phase2682/SOTA_TriBander_LCD/Layout Files/Relay_LCD k7 back.jpg

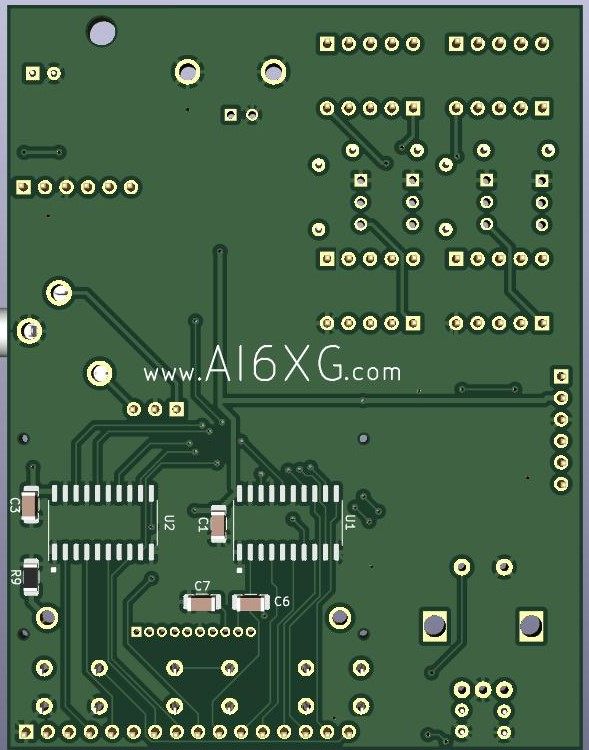
Layout Files/Relay_LCD k7 back.jpg
