phase2682/SOTA_TriBander_LCD/Layout Files/Relay_LCD k7 front.jpg

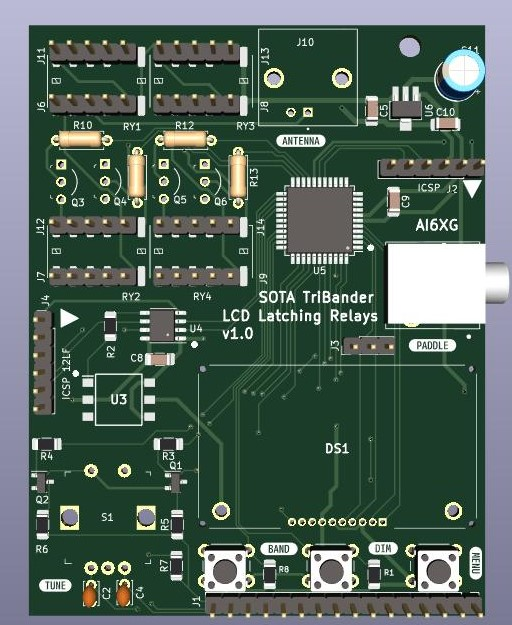
Layout Files/Relay_LCD k7 front.jpg
