phase2682/SOTA_TriBander_LCD/README.md

# SOTA_TriBander_LCD
Replacing the LED display with a LCD on the SOTA  Tri-Bander CW transceiver
https://www.ai6xg.com/post/lcd-display-for-the-kd1jv-tribander
