phase2682/SOTA_TriBander_LCD/Schematics/Relay_LCD k7.pdf

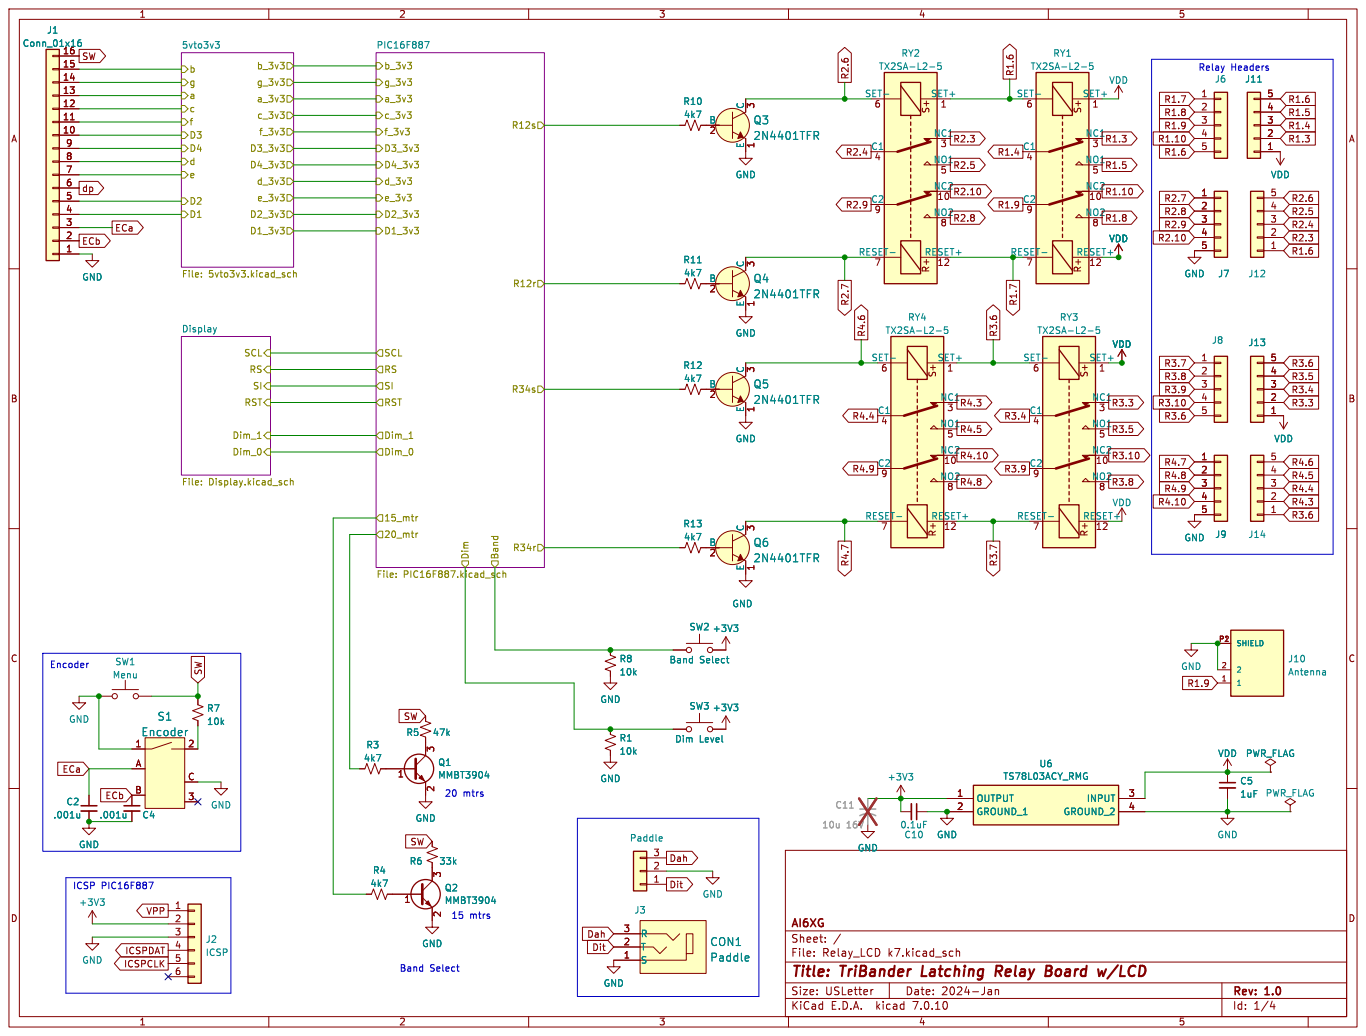
[picture p3: page 1]

Dah Dit Dah Dit ICSPDAT

Id: 1/4 Title: TriBander Latching Relay Board w/LCD

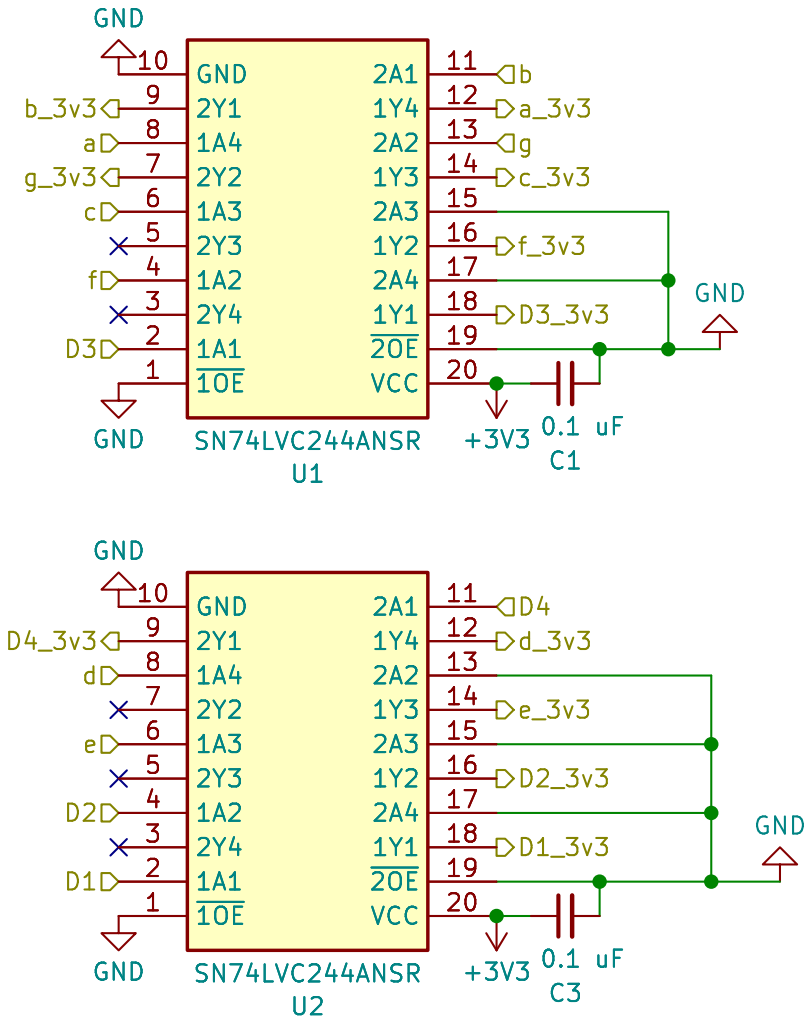
[picture p4: page 2]

Id: 2/4 Title: TriBander Latching Relay Board w/LCD

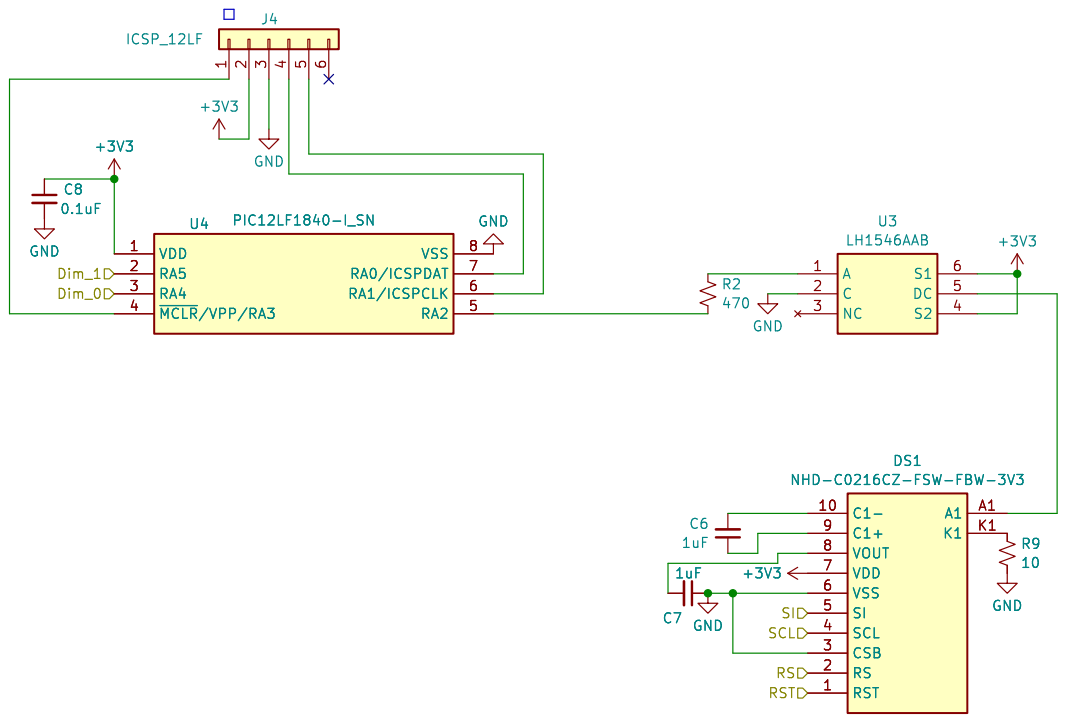
[picture p5: page 3]

File: Display.kicad_sch Sheet: /Display/ AI6XG

Id: 3/4 Title: TriBander Latching Relay Board w/LCD

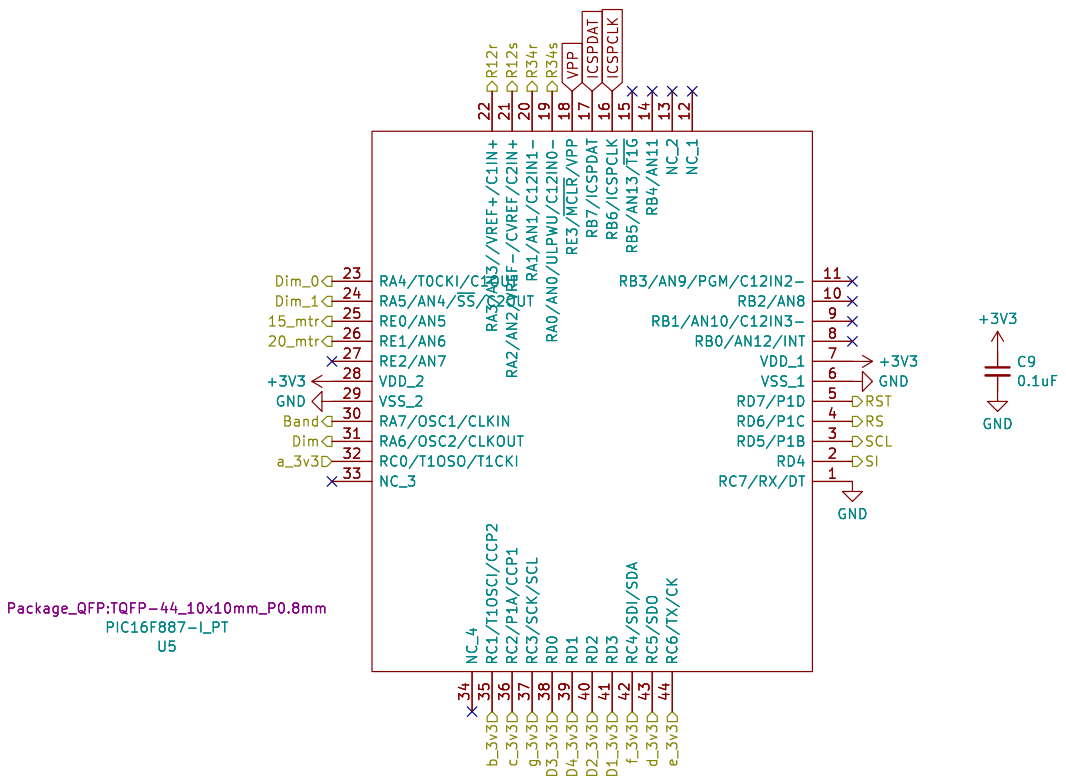
[picture p6: page 4]

Id: 4/4 Title: TriBander Latching Relay Board w/LCD
