phase2682/SOTA_TriBander_LCD/Layout Files/Relay_LCD k7.kicad_pcb

## KiCad design Layout Files/Relay_LCD k7.kicad_pcb (2024-05-09)

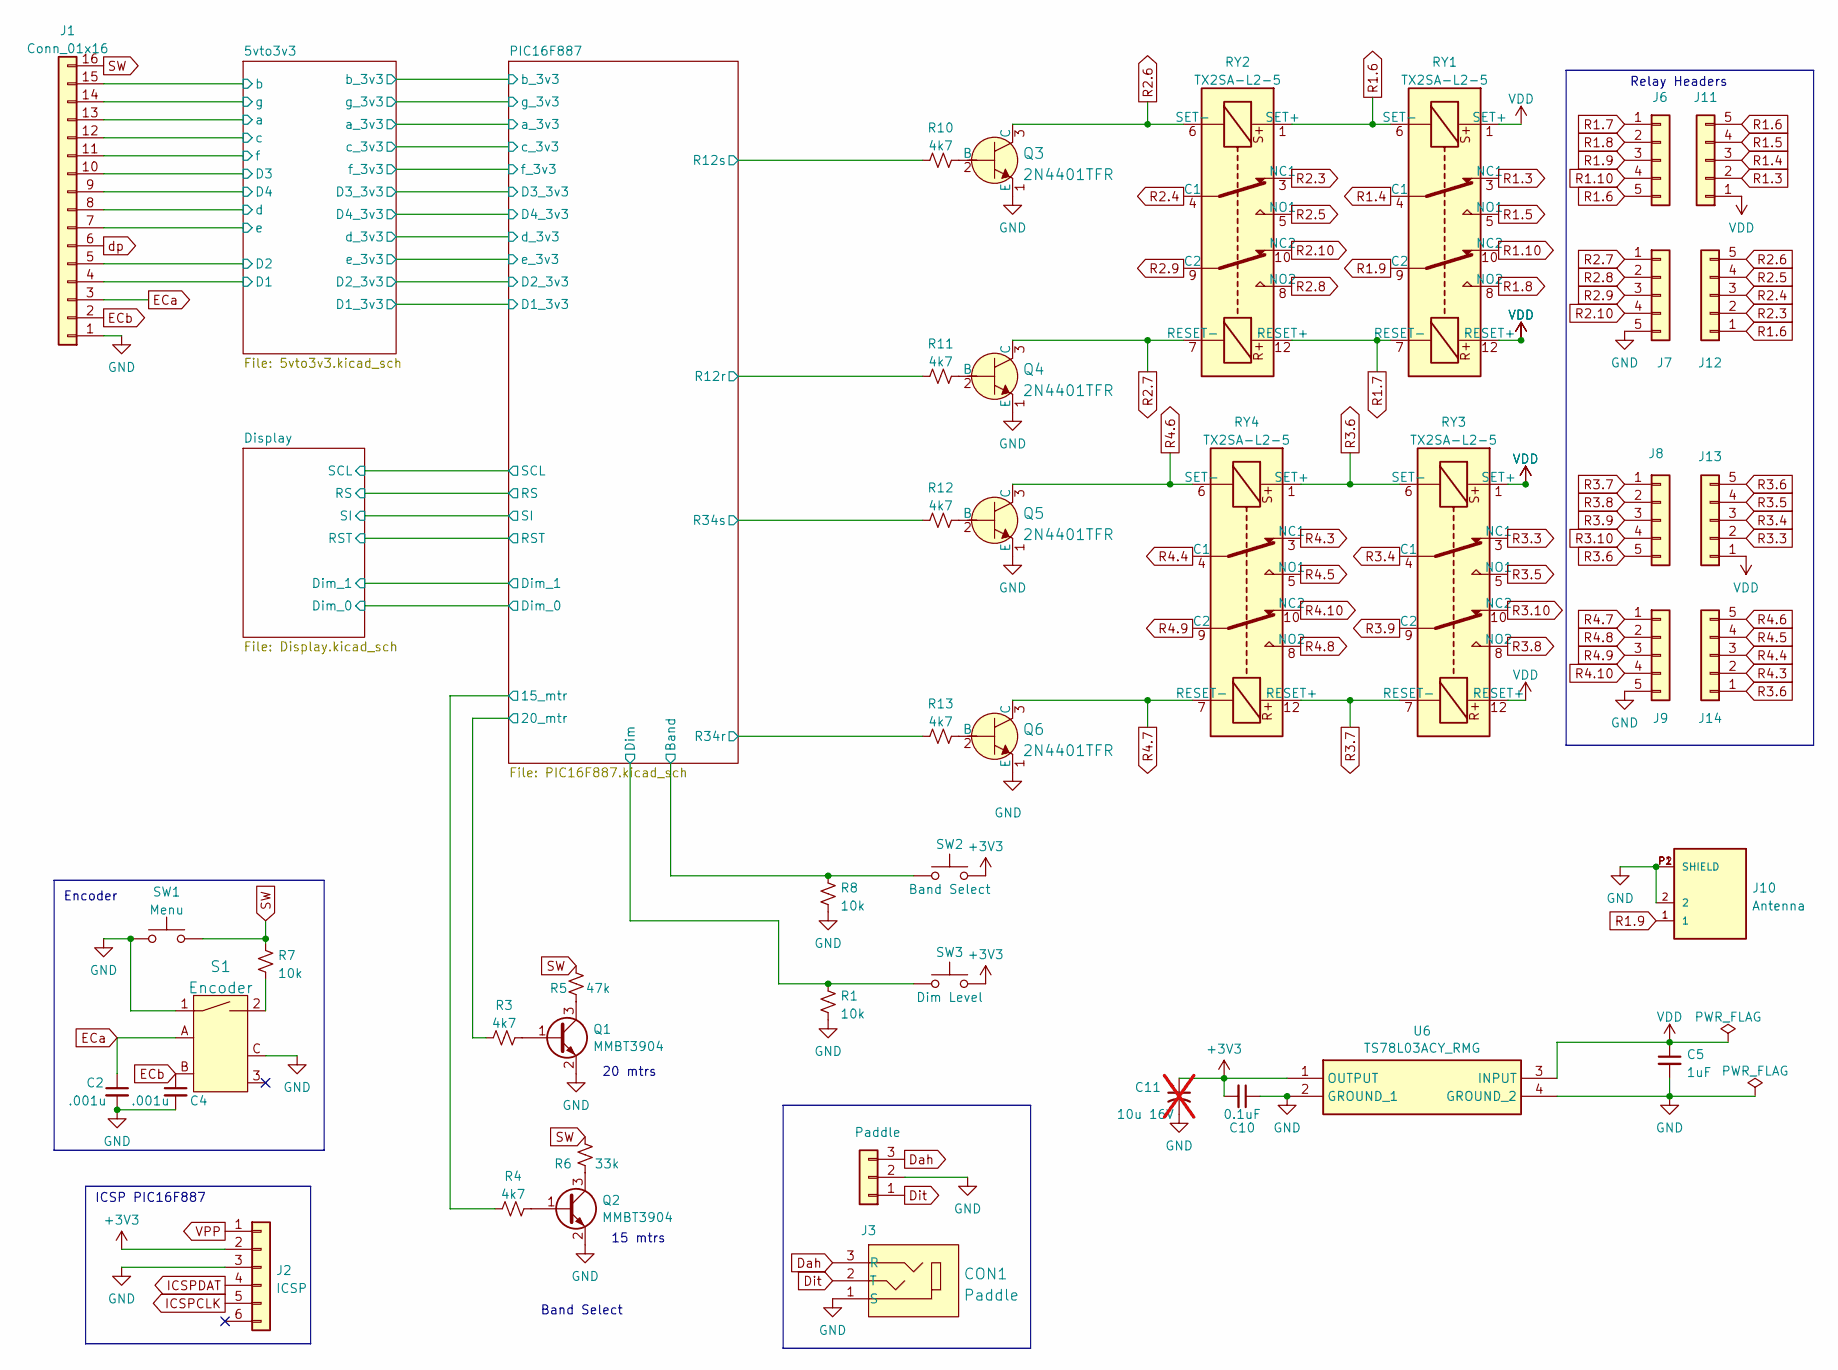
[picture p7: schematic Relay_LCD k7.kicad_sch, TriBander Latching Relay Board w/LCD]

Parts:
C2, C4: .001u; C_Disc_D3.4mm_W2.1mm_P2.50mm
C5: 1uF; C_1206_3216Metric_Pad1.33x1.80mm_HandSolder
C10: 0.1uF; C_1206_3216Metric_Pad1.33x1.80mm_HandSolder
C11: 10u 16V; CP_Radial_D6.3mm_P2.50mm; not fitted
CON1: Paddle; CUI_SJ1-3513N round pin; MPN SJ1-3523N; Digi-Key_PN CP1-3523N-ND
J1: Conn_01x16; PinHeader_1x16_P2.54mm_Vertical
J2: ICSP; PinHeader_1x06_P2.54mm_Vertical
J3: Paddle; PinHeader_1x03_P2.54mm_Vertical
J6, J7, J8, J9, J11, J12, J13, J14: Conn_01x05; PinHeader_1x05_P2.54mm_Vertical
J10: Antenna; CONN_1-1337543-0
Q1, Q2: MMBT3904; SOT-23
Q3, Q4, Q5, Q6: 2N4401TFR; TO-92-3_Formed_Leads; MPN 2N4401TFR; Digi-Key_PN 2N4401D26ZCT-ND
R1, R7, R8: 10k; R_1206_3216Metric_Pad1.30x1.75mm_HandSolder
R3, R4: 4k7; R_1206_3216Metric_Pad1.30x1.75mm_HandSolder
R5: 47k; R_1206_3216Metric_Pad1.30x1.75mm_HandSolder
R6: 33k; R_1206_3216Metric_Pad1.30x1.75mm_HandSolder
R10, R11, R12, R13: 4k7; R THT .25W minP
RY1, RY2, RY3, RY4: TX2SA-L2-5; Relay_DPDT_Kemet_EE2_NU_DoubleCoil
S1: Encoder; Rotary_Encoder_Switched_PEC11R; MPN PEC11R-4215F-S0024; Digi-Key_PN PEC11R-4215F-S0024-ND
SW1: Menu; SW_PUSH_6mm
SW2: Band Select; SW_PUSH_6mm
SW3: Dim Level; SW_PUSH_6mm
U6: TS78L03ACY_RMG; SOT-89-3_Handsoldering; Mouser Part Number 821-TS78L03ACYRMG

Connections:
+3V3: C10.2, C11.1, J2.2, SW2.2, SW3.2, U6.1 (OUTPUT); also elsewhere on the board
/5vto3v3/D1: J1.4; also elsewhere on the board
/5vto3v3/D2: J1.5; also elsewhere on the board
/5vto3v3/D3: J1.10; also elsewhere on the board
/5vto3v3/D4: J1.9; also elsewhere on the board
/5vto3v3/a: J1.13; also elsewhere on the board
/5vto3v3/b: J1.15; also elsewhere on the board
/5vto3v3/c: J1.12; also elsewhere on the board
/5vto3v3/d: J1.8; also elsewhere on the board
/5vto3v3/e: J1.7; also elsewhere on the board
/5vto3v3/f: J1.11; also elsewhere on the board
/5vto3v3/g: J1.14; also elsewhere on the board
/PIC16F887/15_mtr: R4.1; also elsewhere on the board
/PIC16F887/20_mtr: R3.1; also elsewhere on the board
/PIC16F887/Band: R8.2, SW2.1; also elsewhere on the board
/PIC16F887/Dim: R1.2, SW3.1; also elsewhere on the board
/PIC16F887/R12r: R11.1; also elsewhere on the board
/PIC16F887/R12s: R10.1; also elsewhere on the board
/PIC16F887/R34r: R13.1; also elsewhere on the board
/PIC16F887/R34s: R12.1; also elsewhere on the board
Dah: CON1.3 (R), J3.3
Dit: CON1.2 (T), J3.1
ECa: C2.1, J1.3, S1.A (CH_A)
ECb: C4.1, J1.2, S1.B (CH_B)
GND: C2.2, C4.2, C5.2, C10.1, C11.2, CON1.1 (S), J1.1, J2.3, J3.2, J7.5, J9.5, J10.2, J10.P1 (SHIELD), J10.P2 (SHIELD), Q1.2 (E), Q2.2 (E), Q3.1 (E), Q4.1 (E), Q5.1 (E), Q6.1 (E), R1.1, R8.1, S1.1, S1.C (COM), SW1.1, U6.2 (GROUND_1), U6.4 (GROUND_2); also elsewhere on the board
ICSPCLK: J2.5; also elsewhere on the board
ICSPDAT: J2.4; also elsewhere on the board
unnamed: Q1.1 (B), R3.2
unnamed: Q1.3 (C), R5.2
unnamed: Q2.1 (B), R4.2
unnamed: Q2.3 (C), R6.2
unnamed: Q3.2 (B), R10.2
unnamed: Q4.2 (B), R11.2
unnamed: Q5.2 (B), R12.2
unnamed: Q6.2 (B), R13.2
unnamed: R7.2, S1.2
R1.3: J11.2, RY1.3 (NC1)
R1.4: J11.3, RY1.4 (C1)
R1.5: J11.4, RY1.5 (NO1)
R1.6: J6.5, J11.5, J12.1, RY1.6 (SET-), RY2.1 (SET+)
R1.7: J6.1, RY1.7 (RESET-), RY2.12 (RESET+)
R1.8: J6.2, RY1.8 (NO2)
R1.9: J6.3, J10.1, RY1.9 (C2)
R1.10: J6.4, RY1.10 (NC2)
R2.3: J12.2, RY2.3 (NC1)
R2.4: J12.3, RY2.4 (C1)
R2.5: J12.4, RY2.5 (NO1)
R2.6: J12.5, Q3.3 (C), RY2.6 (SET-)
R2.7: J7.1, Q4.3 (C), RY2.7 (RESET-)
R2.8: J7.2, RY2.8 (NO2)
R2.9: J7.3, RY2.9 (C2)
R2.10: J7.4, RY2.10 (NC2)
R3.3: J13.2, RY3.3 (NC1)
R3.4: J13.3, RY3.4 (C1)
R3.5: J13.4, RY3.5 (NO1)
R3.6: J8.5, J13.5, J14.1, RY3.6 (SET-), RY4.1 (SET+)
R3.7: J8.1, RY3.7 (RESET-), RY4.12 (RESET+)
R3.8: J8.2, RY3.8 (NO2)
R3.9: J8.3, RY3.9 (C2)
R3.10: J8.4, RY3.10 (NC2)
R4.3: J14.2, RY4.3 (NC1)
R4.4: J14.3, RY4.4 (C1)
R4.5: J14.4, RY4.5 (NO1)
R4.6: J14.5, Q5.3 (C), RY4.6 (SET-)
R4.7: J9.1, Q6.3 (C), RY4.7 (RESET-)
R4.8: J9.2, RY4.8 (NO2)
R4.9: J9.3, RY4.9 (C2)
R4.10: J9.4, RY4.10 (NC2)
SW: J1.16, R5.1, R6.1, R7.1, SW1.2
VDD: C5.1, J11.1, J13.1, RY1.1 (SET+), RY1.12 (RESET+), RY3.1 (SET+), RY3.12 (RESET+), U6.3 (INPUT)
VPP: J2.1; also elsewhere on the board
dp: J1.6

Notes on the sheet:
20 mtrs
15 mtrs
Relay Headers
ICSP PIC16F887
Encoder
Band Select

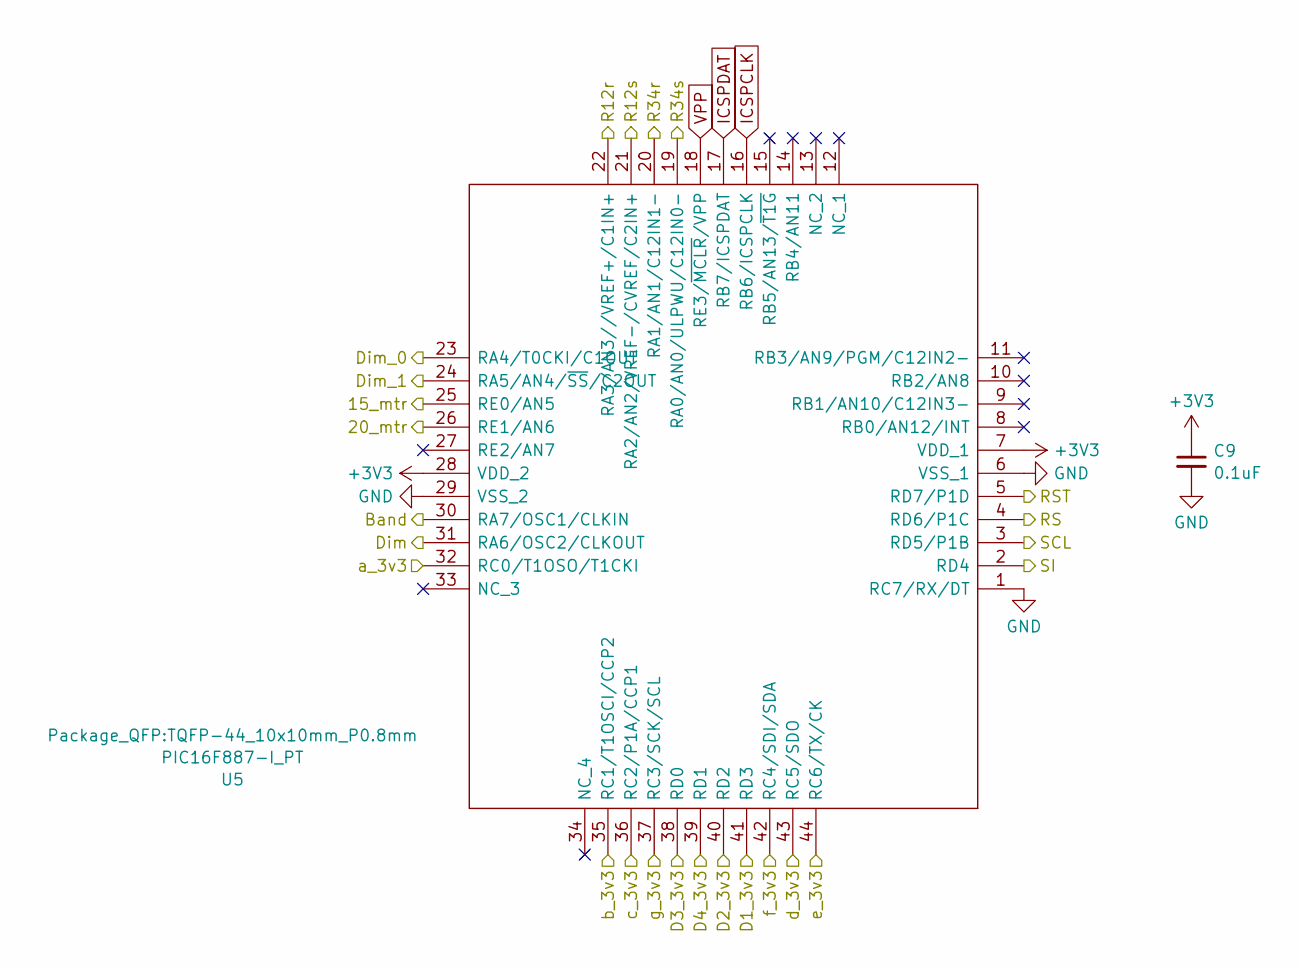
[picture p8: schematic PIC16F887.kicad_sch, TriBander Latching Relay Board w/LCD]

Parts:
C9: 0.1uF; C_1206_3216Metric_Pad1.33x1.80mm_HandSolder
U5: PIC16F887-I_PT; TQFP-44_10x10mm_P0.8mm; Mouser Part Number 579-PIC16F887-I/PT

Connections:
+3V3: C9.1, U5.7 (VDD_1), U5.28 (VDD_2); also elsewhere on the board
/5vto3v3/D1_3v3: U5.41 (RD3); also elsewhere on the board
/5vto3v3/D2_3v3: U5.40 (RD2); also elsewhere on the board
/5vto3v3/D3_3v3: U5.38 (RD0); also elsewhere on the board
/5vto3v3/D4_3v3: U5.39 (RD1); also elsewhere on the board
/5vto3v3/a_3v3: U5.32 (RC0/T1OSO/T1CKI); also elsewhere on the board
/5vto3v3/b_3v3: U5.35 (RC1/T1OSCI/CCP2); also elsewhere on the board
/5vto3v3/c_3v3: U5.36 (RC2/P1A/CCP1); also elsewhere on the board
/5vto3v3/d_3v3: U5.43 (RC5/SDO); also elsewhere on the board
/5vto3v3/e_3v3: U5.44 (RC6/TX/CK); also elsewhere on the board
/5vto3v3/f_3v3: U5.42 (RC4/SDI/SDA); also elsewhere on the board
/5vto3v3/g_3v3: U5.37 (RC3/SCK/SCL); also elsewhere on the board
/Display/Dim_0: U5.23 (RA4/T0CKI/C1OUT); also elsewhere on the board
/Display/Dim_1: U5.24 (RA5/AN4/~SS/C2OUT); also elsewhere on the board
/Display/RS: U5.4 (RD6/P1C); also elsewhere on the board
/Display/RST: U5.5 (RD7/P1D); also elsewhere on the board
/Display/SCL: U5.3 (RD5/P1B); also elsewhere on the board
/Display/SI: U5.2 (RD4); also elsewhere on the board
/PIC16F887/15_mtr: U5.25 (RE0/AN5); also elsewhere on the board
/PIC16F887/20_mtr: U5.26 (RE1/AN6); also elsewhere on the board
/PIC16F887/Band: U5.30 (RA7/OSC1/CLKIN); also elsewhere on the board
/PIC16F887/Dim: U5.31 (RA6/OSC2/CLKOUT); also elsewhere on the board
/PIC16F887/R12r: U5.22 (RA3/AN3//VREF+/C1IN+); also elsewhere on the board
/PIC16F887/R12s: U5.21 (RA2/AN2/VREF-/CVREF/C2IN+); also elsewhere on the board
/PIC16F887/R34r: U5.20 (RA1/AN1/C12IN1-); also elsewhere on the board
/PIC16F887/R34s: U5.19 (RA0/AN0/ULPWU/C12IN0-); also elsewhere on the board
GND: C9.2, U5.1 (RC7/RX/DT), U5.6 (VSS_1), U5.29 (VSS_2); also elsewhere on the board
ICSPCLK: U5.16 (RB6/ICSPCLK); also elsewhere on the board
ICSPDAT: U5.17 (RB7/ICSPDAT); also elsewhere on the board
VPP: U5.18 (RE3/~MCLR/VPP); also elsewhere on the board

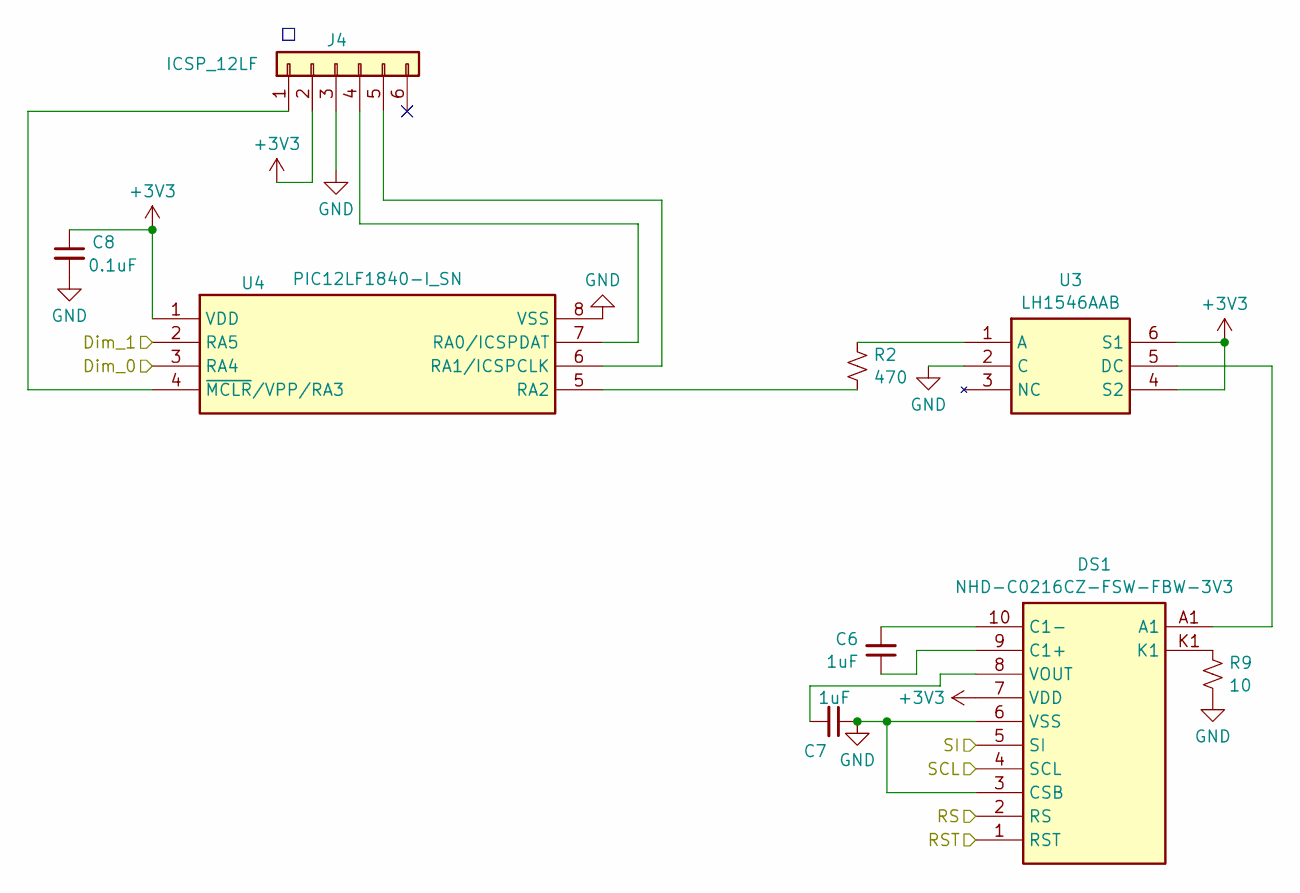
[picture p9: schematic Display.kicad_sch, TriBander Latching Relay Board w/LCD]

Parts:
C6, C7: 1uF; C_1206_3216Metric_Pad1.33x1.80mm_HandSolder
C8: 0.1uF; C_1206_3216Metric_Pad1.33x1.80mm_HandSolder
DS1: NHD-C0216CZ-FSW-FBW-3V3; NHDC0216CZFSWFBW3V3; Mouser Part Number 763-C0216CZ-FSWFBW3V
J4: ICSP_12LF; PinHeader_1x06_P2.54mm_Vertical
R2: 470; R_1206_3216Metric_Pad1.30x1.75mm_HandSolder
R9: 10; R_1206_3216Metric_Pad1.30x1.75mm_HandSolder
U3: LH1546AAB; SOP254P980X425-6N; Mouser Part Number 782-LH1546AABTR
U4: PIC12LF1840-I_SN; SO-8_3.9x4.9mm_P1.27mm; Mouser Part Number 579-PIC12LF1840-I/SN

Connections:
+3V3: C8.1, DS1.7 (VDD), J4.2, U3.4 (S2), U3.6 (S1), U4.1 (VDD); also elsewhere on the board
/Display/Dim_0: U4.3 (RA4); also elsewhere on the board
/Display/Dim_1: U4.2 (RA5); also elsewhere on the board
/Display/RS: DS1.2 (RS); also elsewhere on the board
/Display/RST: DS1.1 (RST); also elsewhere on the board
/Display/SCL: DS1.4 (SCL); also elsewhere on the board
/Display/SI: DS1.5 (SI); also elsewhere on the board
GND: C7.1, C8.2, DS1.3 (CSB), DS1.6 (VSS), J4.3, R9.2, U3.2 (C), U4.8 (VSS); also elsewhere on the board
unnamed: C6.1, DS1.9 (C1+)
unnamed: C6.2, DS1.10 (C1-)
unnamed: DS1.K1, R9.1
unnamed: C7.2, DS1.8 (VOUT)
unnamed: J4.1, U4.4 (~MCLR/VPP/RA3)
unnamed: J4.4, U4.7 (RA0/ICSPDAT)
unnamed: J4.5, U4.6 (RA1/ICSPCLK)
unnamed: R2.1, U3.1 (A)
unnamed: DS1.A1, U3.5 (DC)
unnamed: R2.2, U4.5 (RA2)

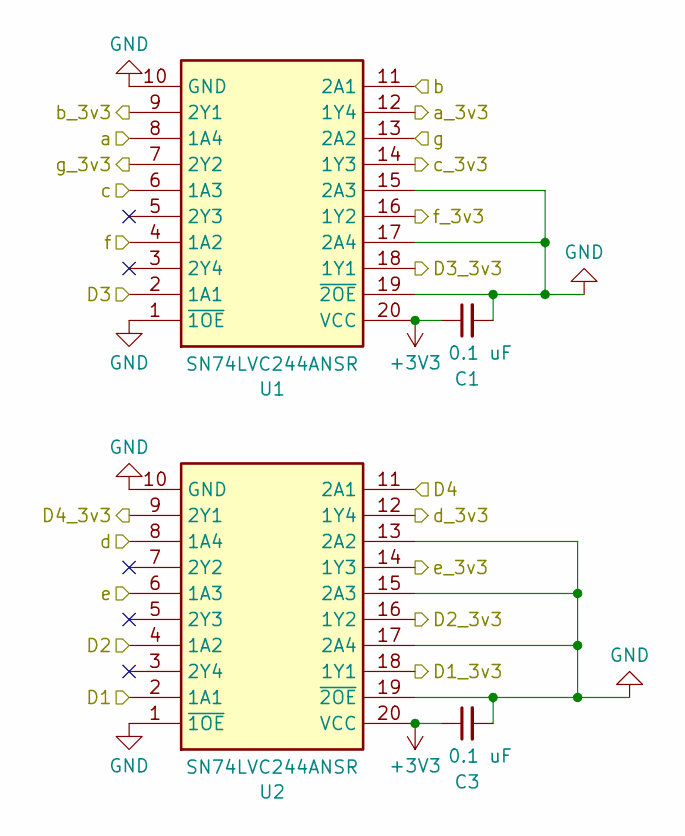
[picture p10: schematic 5vto3v3.kicad_sch, TriBander Latching Relay Board w/LCD]

Parts:
C1, C3: 0.1 uF; C_1206_3216Metric_Pad1.33x1.80mm_HandSolder
U1, U2: SN74LVC244ANSR; SO-20_5.3x12.6mm_P1.27mm; Mouser Part Number 595-SN74LVC244ANSR

Connections:
+3V3: C1.1, C3.1, U1.20 (VCC), U2.20 (VCC); also elsewhere on the board
/5vto3v3/D1: U2.2 (1A1); also elsewhere on the board
/5vto3v3/D1_3v3: U2.18 (1Y1); also elsewhere on the board
/5vto3v3/D2: U2.4 (1A2); also elsewhere on the board
/5vto3v3/D2_3v3: U2.16 (1Y2); also elsewhere on the board
/5vto3v3/D3: U1.2 (1A1); also elsewhere on the board
/5vto3v3/D3_3v3: U1.18 (1Y1); also elsewhere on the board
/5vto3v3/D4: U2.11 (2A1); also elsewhere on the board
/5vto3v3/D4_3v3: U2.9 (2Y1); also elsewhere on the board
/5vto3v3/a: U1.8 (1A4); also elsewhere on the board
/5vto3v3/a_3v3: U1.12 (1Y4); also elsewhere on the board
/5vto3v3/b: U1.11 (2A1); also elsewhere on the board
/5vto3v3/b_3v3: U1.9 (2Y1); also elsewhere on the board
/5vto3v3/c: U1.6 (1A3); also elsewhere on the board
/5vto3v3/c_3v3: U1.14 (1Y3); also elsewhere on the board
/5vto3v3/d: U2.8 (1A4); also elsewhere on the board
/5vto3v3/d_3v3: U2.12 (1Y4); also elsewhere on the board
/5vto3v3/e: U2.6 (1A3); also elsewhere on the board
/5vto3v3/e_3v3: U2.14 (1Y3); also elsewhere on the board
/5vto3v3/f: U1.4 (1A2); also elsewhere on the board
/5vto3v3/f_3v3: U1.16 (1Y2); also elsewhere on the board
/5vto3v3/g: U1.13 (2A2); also elsewhere on the board
/5vto3v3/g_3v3: U1.7 (2Y2); also elsewhere on the board
GND: C1.2, C3.2, U1.1 (~1OE), U1.10 (GND), U1.15 (2A3), U1.17 (2A4), U1.19 (~2OE), U2.1 (~1OE), U2.10 (GND), U2.13 (2A2), U2.15 (2A3), U2.17 (2A4), U2.19 (~2OE); also elsewhere on the board

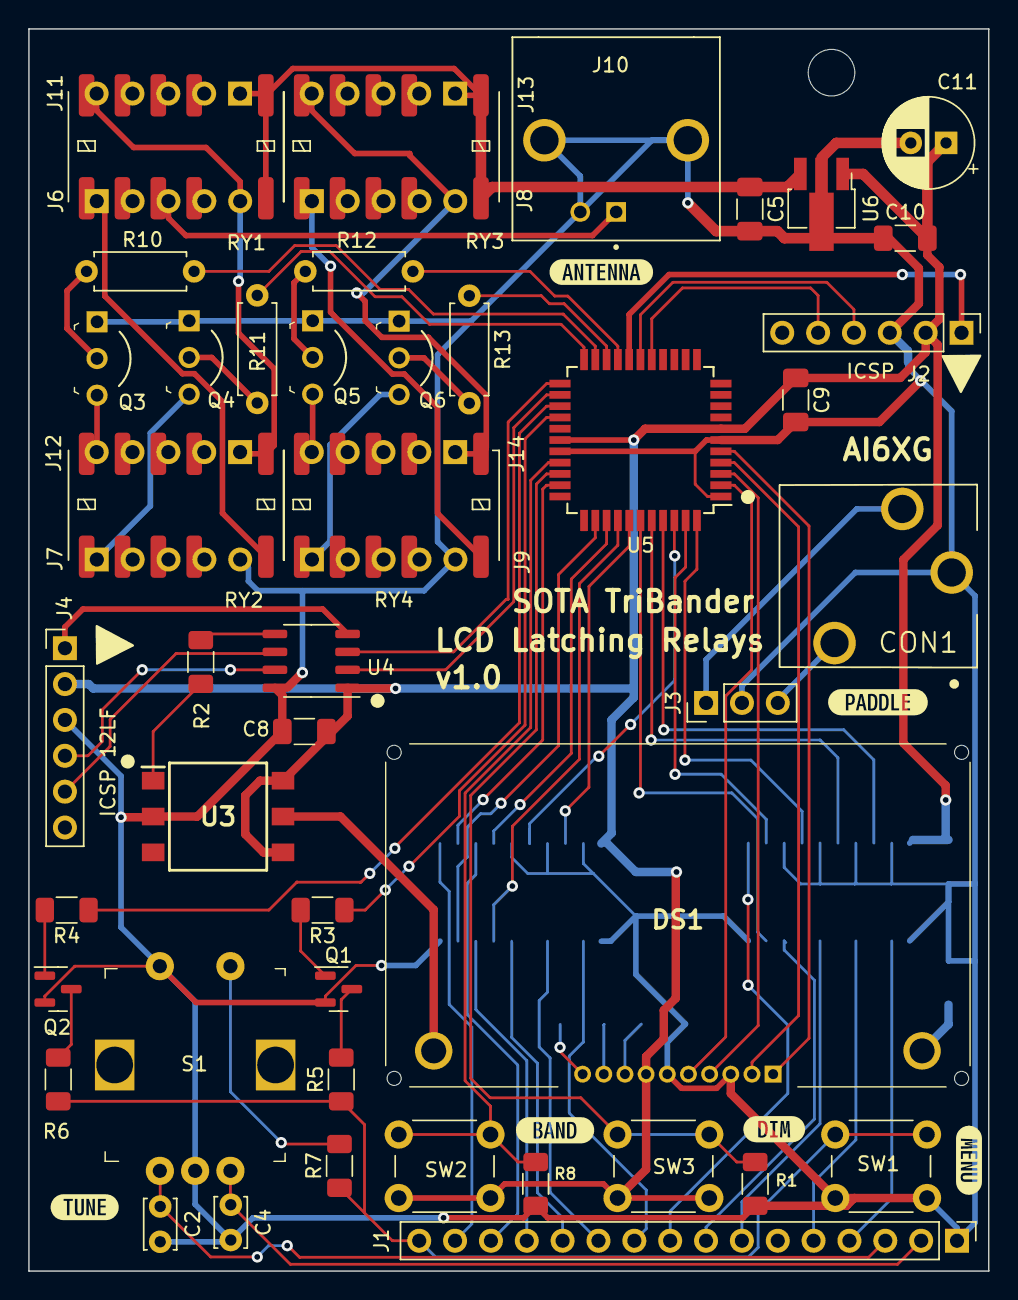
[picture p11: board Relay_LCD k7.kicad_pcb from above]

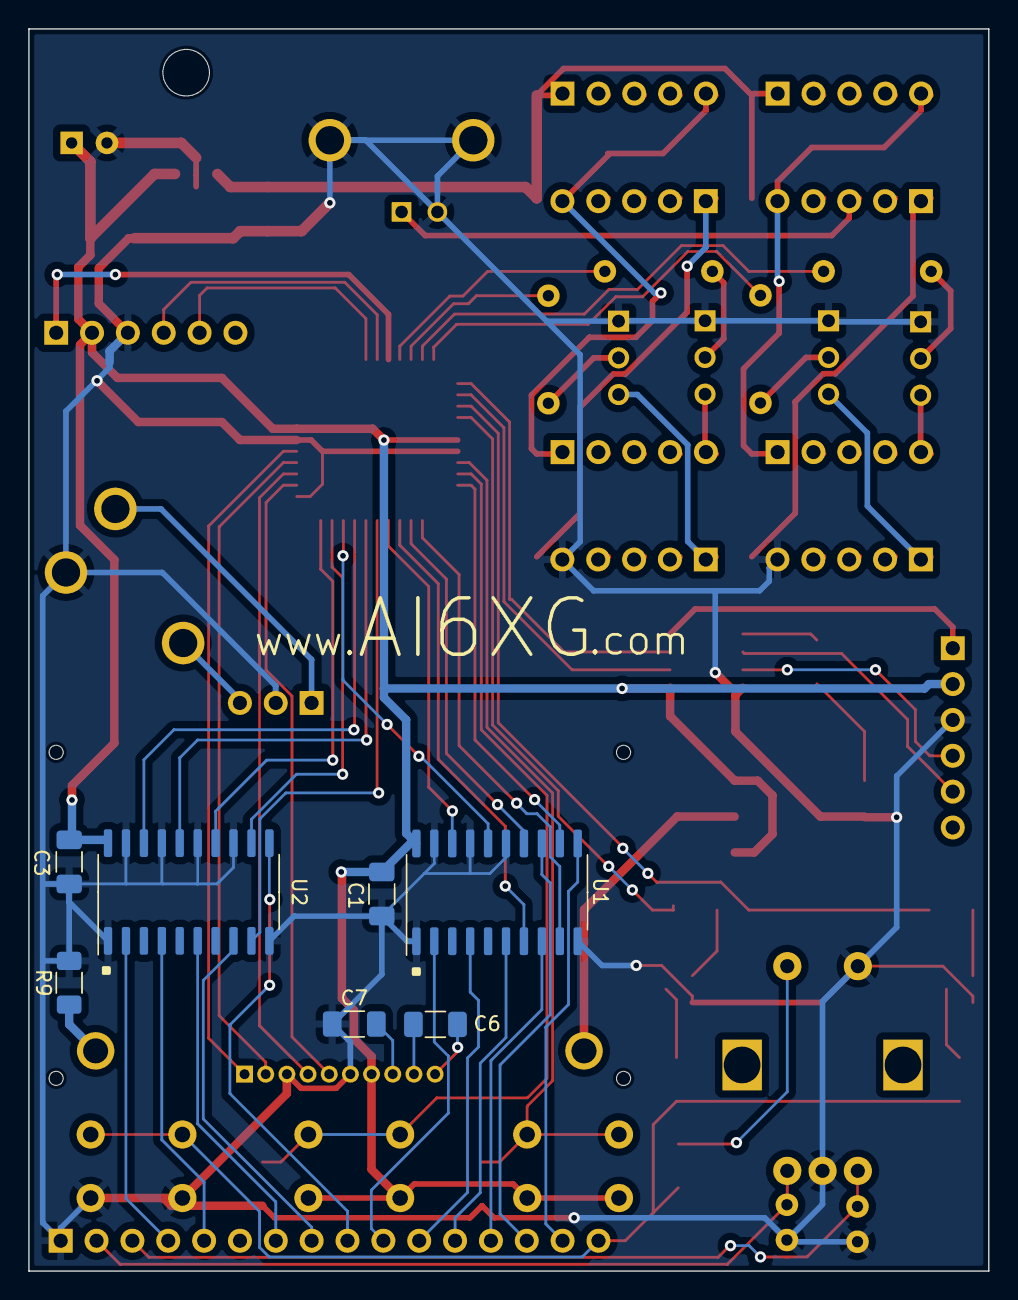
[picture p12: board Relay_LCD k7.kicad_pcb from below]

Board: 2 copper layers, 68.0 x 88.0 mm, 65 parts (7 on the bottom side), 98 nets.

Other parts of the board:
kibuzzard-659F9941: G***; kibuzzard-659F9941
kibuzzard-659F9955: G***; kibuzzard-659F9955
kibuzzard-6406D9A6: G***; kibuzzard-6406D9A6
kibuzzard-6406D9EC: G***; kibuzzard-6406D9EC
kibuzzard-6406DC87: G***; kibuzzard-6406DC87
kibuzzard-6407CA45: G***; kibuzzard-6407CA45
