phase2682/SOTA_TriBander_LCD/Microcontroller_code/PIC12LF1840/configBits.h

/* 
 * File:   configBits.h
 * Author: Dan Koellen AI6XG
 *
 * Created on December 21, 2023, 11:05 PM
 */

#ifndef CONFIGBITS_H
#define	CONFIGBITS_H

#ifdef	__cplusplus
extern "C" {
#endif

// PIC12LF1840 Configuration Bit Settings
// 'C' source line config statements
// CONFIG1
#pragma config FOSC = INTOSC    // Oscillator Selection (INTOSC oscillator: I/O function on CLKIN pin)
#pragma config WDTE = OFF       // Watchdog Timer Enable (WDT disabled)
#pragma config PWRTE = OFF      // Power-up Timer Enable (PWRT disabled)
#pragma config MCLRE = OFF      // MCLR Pin Function Select (MCLR/VPP pin function is digital input)
#pragma config CP = OFF         // Flash Program Memory Code Protection (Program memory code protection is disabled)
#pragma config CPD = OFF        // Data Memory Code Protection (Data memory code protection is disabled)
#pragma config BOREN = OFF      // Brown-out Reset Enable (Brown-out Reset disabled)
#pragma config CLKOUTEN = OFF   // Clock Out Enable (CLKOUT function is disabled. I/O or oscillator function on the CLKOUT pin)
#pragma config IESO = OFF       // Internal/External Switchover (Internal/External Switchover mode is disabled)
#pragma config FCMEN = OFF      // Fail-Safe Clock Monitor Enable (Fail-Safe Clock Monitor is disabled)

// CONFIG2
#pragma config WRT = OFF        // Flash Memory Self-Write Protection (Write protection off)
#pragma config PLLEN = OFF      // PLL Enable (4x PLL disabled)
#pragma config STVREN = OFF     // Stack Overflow/Underflow Reset Enable (Stack Overflow or Underflow will not cause a Reset)
#pragma config BORV = LO        // Brown-out Reset Voltage Selection (Brown-out Reset Voltage (Vbor), low trip point selected.)
#pragma config DEBUG = OFF      // In-Circuit Debugger Mode (In-Circuit Debugger disabled, ICSPCLK and ICSPDAT are general purpose I/O pins)
#pragma config LVP = OFF        // Low-Voltage Programming Enable (High-voltage on MCLR/VPP must be used for programming)

// #pragma config statements should precede project file includes.
// Use project enums instead of #define for ON and OFF.

//#include <xc.h>




#ifdef	__cplusplus
}
#endif

#endif	/* CONFIGBITS_H */
