phase2682/SOTA_TriBander_LCD/Microcontroller_code/PIC16F887/Binary_to_BCD.h

//generates BCD
//bcd10000, bcd1000, bcd100,bcdtens, bcdunits
void binary_to_BCDconvert(int nbin);	//declare binary_to_BCDconvert function

unsigned char bcd10000;				//number of ten thousands
unsigned char bcd1000;				//number of thousands
unsigned char bcd100;				//number of hundreds
unsigned char bcdtens;				//number of tens
unsigned char bcdunits;				//number of ones
